GTshenmi/AI-SmartCar/AI Visual/SoftWare/Source Code/AIVisionCar/Example/example/readme.txt

使用软件
- Keil MDK 5.25
- IAR embedded Workbench 8.40（IAR8.40版本不支持中文路径）

波特率115200  8位数据位 1位停止位 没有奇偶校验

如果使用龙邱配套的DAPLINK 直接插上即可
如果使用串口模块（串口蓝牙，USB转TTL或者其他串口）
将 L14 连接串口模块（串口蓝牙）的 TX上
将 K14 连接串口模块（串口蓝牙）的 RX上
共地

一个例子工程，可以在这个上面构建自己的程序

128KB   ITCRAM   重要代码执行域
256KB   DTCRAM   常用数据域和栈
640KB   OCRAM    堆域和不常用数据域

注意如果下不进去程序，供电正常电源灯不亮请联系客服寄回维修
如果电源灯亮 请将核心板上的两个拨码开关拨到另一面，下载完成后再拨回来
