GTshenmi/AI-SmartCar/AI Visual/SoftWare/Source Code/AIVisionCar/更新说明.txt

2019/11/26  增加RT1064_IO分配说明

2019/11/25  增加1064必读说明

2019/11/25  更新入门手册至2.0版本

2019/11/25  替换PIT.c/.h以及SOFTIIC.c/.h  （已替换）

2019/10/15  优化模拟IIC驱动

2019/10/12  优化LQ_PIT.c 解决PIT通道1不能进入中断问题

2019/10/08  优化GPT驱动文件

2019/09/06  优化LQ_SYSTICK.c文件

2019/08/30  优化TFT1.8寸屏初始化程序，提高刷屏速度

2019/08/30  新增SD卡拍照存卡例程

2019/08/26  新增DMA内存To内存测试例程

2019/08/22  新增CAN收发例程

2019/08/19  新增LQ_GPIO.c驱动程序
