GTshenmi/AI-SmartCar/AI Electomagnetic/Simulation And Analysis/Correlation Analysis/模型分析/All.png

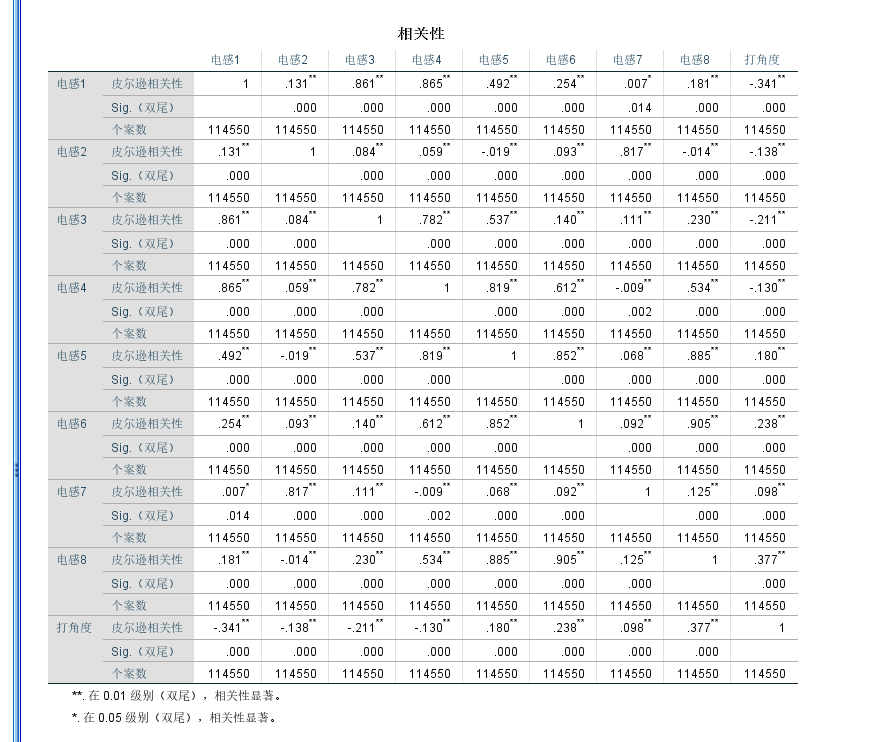
AI Electomagnetic/Simulation And Analysis/Correlation Analysis/模型分析/All.png
