GTshenmi/AI-SmartCar/AI Electomagnetic/Software/Template/TC377/SmartCar Code Structure.png

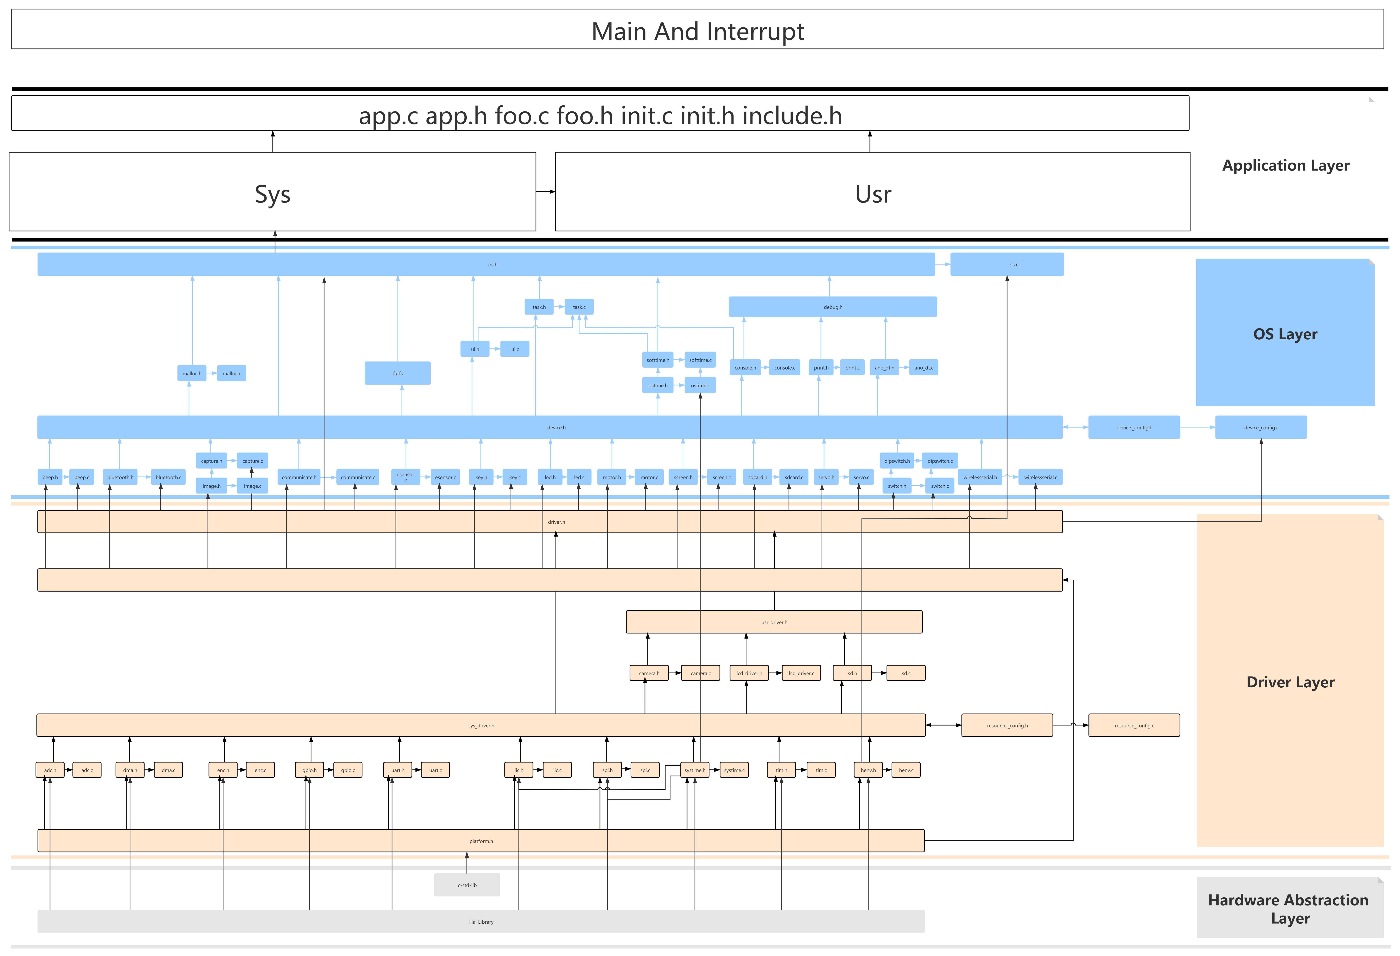
AI Electomagnetic/Software/Template/TC377/SmartCar Code Structure.png
