GTshenmi/AI-SmartCar/AI Electomagnetic/Simulation And Analysis/AI/train_dat/manual.txt

00 01 B4 80 D3 0C EE 80 CB 00 5A 
00 02 B4 80 D3 0C EE 80 CA 00 5A 
00 03 B5 81 D4 0C EF 80 CB BB 5A 
00 04 B5 81 D3 0D EE 80 CB BB 5A 
00 05 B5 80 D4 0C EE 80 CB D7 5A 
00 06 B5 81 D4 0C EE 80 CB D7 5A 
00 07 B5 81 D3 0C EF 80 CB D7 5A 
00 08 B5 81 D4 0C EF 80 CB D7 5A 
00 09 B5 80 D4 0D EF 81 CB D7 5A 
00 0A B5 81 D4 0C EF 81 CB CF 5A 
00 0B B4 81 D4 0C EE 80 CB CF 5A 
00 0C B5 81 D3 0C EE 80 CB CF 5A 
00 0D B6 81 D4 0D EF 81 CB D2 5A 
00 0E B5 80 D4 0C EF 80 CB D2 5A 
00 0F B5 81 D4 0C EE 80 CB D2 5A 
00 10 B5 80 D4 0C EF 80 CB D2 5A 
00 11 B5 81 D3 0C EE 80 CB D2 5A 
00 12 B4 81 D4 0D EF 80 CB D2 5A 
00 13 B5 80 D3 0C EF 80 CB D2 5A 
00 14 B5 81 D3 0C EE 80 CB DA 5A 
00 15 B5 81 D3 0C EF 80 CB DA 5A 
00 16 B5 81 D3 0C EE 80 CB DA 5A 
00 17 B5 81 D4 0C EE 81 CA CF 5A 
00 18 B5 81 D3 0C EE 80 CB CF 5A 
00 19 B5 80 D4 0C EE 80 CB DA 5A 
00 1A B5 81 D4 0D EE 80 CA DA 5A 
00 1B B4 81 D4 0C EE 80 CA DA 5A 
00 1C B5 81 D4 0C EE 80 CB D7 5A 
00 1D B5 81 D4 0C EE 80 CA D7 5A 
00 1E B5 81 D4 0C EE 80 CA D7 5A 
00 1F B5 81 D4 0C EE 80 CB D7 5A 
00 20 B5 80 D4 0C EE 80 CA D7 5A 
00 21 B5 81 D4 0D EE 80 CA DB 5A 
00 22 B5 80 D4 0C EE 81 CA DB 5A 
00 23 B5 81 D4 0C EE 80 CA D9 5A 
00 24 B5 80 D4 0D EE 80 CA D9 5A 
00 25 B5 80 D4 0D EE 80 CA D9 5A 
00 26 B5 81 D5 0D EE 80 CA D9 5A 
00 27 B6 81 D5 0D ED 80 CA D9 5A 
00 28 B5 81 D4 0D ED 80 C9 D9 5A 
00 29 B5 81 D5 0D ED 80 C9 D9 5A 
00 2A B7 81 D5 0D ED 81 CA D9 5A 
00 2B B6 80 D5 0D ED 80 C9 E1 5A 
00 2C B6 81 D5 0D ED 80 C9 E1 5A 
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
2D ED B8 80 D7 0D EA 81 C6 DC 5A 
2D EE B7 80 D7 0F EA 81 C7 D6 5A 
2D EF B7 81 D6 0F EB 81 C7 D6 5A 
2D F0 B6 80 D6 0E EB 81 C7 CD 5A 
2D F1 B7 80 D5 0F EC 82 C8 CD 5A 
2D F2 B6 80 D4 0D EC 82 C9 CD 5A 
2D F3 B6 80 D4 0E ED 82 C9 C2 5A 
2D F4 B6 80 D4 0E ED 82 C9 C2 5A
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
