GTshenmi/AI-SmartCar/AI Electomagnetic/Simulation And Analysis/AI/train_dat/train_dat/test.txt

S 5 S 1.440430 27.392580 26.293950 32.519530 40.869140 49.829100 1.708984 31.094920 E
S 1 S 1.440430 27.392580 26.293950 32.519530 40.869140 49.829100 1.708984 31.094920 E
S 2 S 1.440430 27.392580 26.293950 32.519530 40.869140 49.829100 1.708984 31.094920 E
S 3 S 1.440430 27.392580 26.293950 32.519530 40.869140 49.829100 1.708984 31.094920 E
S 4 S 1.440430 27.392580 26.293950 32.519530 40.869140 49.829100 1.708984 31.094920 E
S 5 S 1.440430 27.392580 26.293950 32.519530 40.869140 49.829100 1.708984 31.094920 E
S 1 S 1.440430 27.392580 26.293950 32.519530 40.869140 49.829100 1.708984 31.094920 E
S 2 S 1.440430 27.392580 26.293950 32.519530 40.869140 49.829100 1.708984 31.094920 E
