GTshenmi/AI-SmartCar/AI Electomagnetic/Hardware/Sheet/AI电磁运放板.pdf

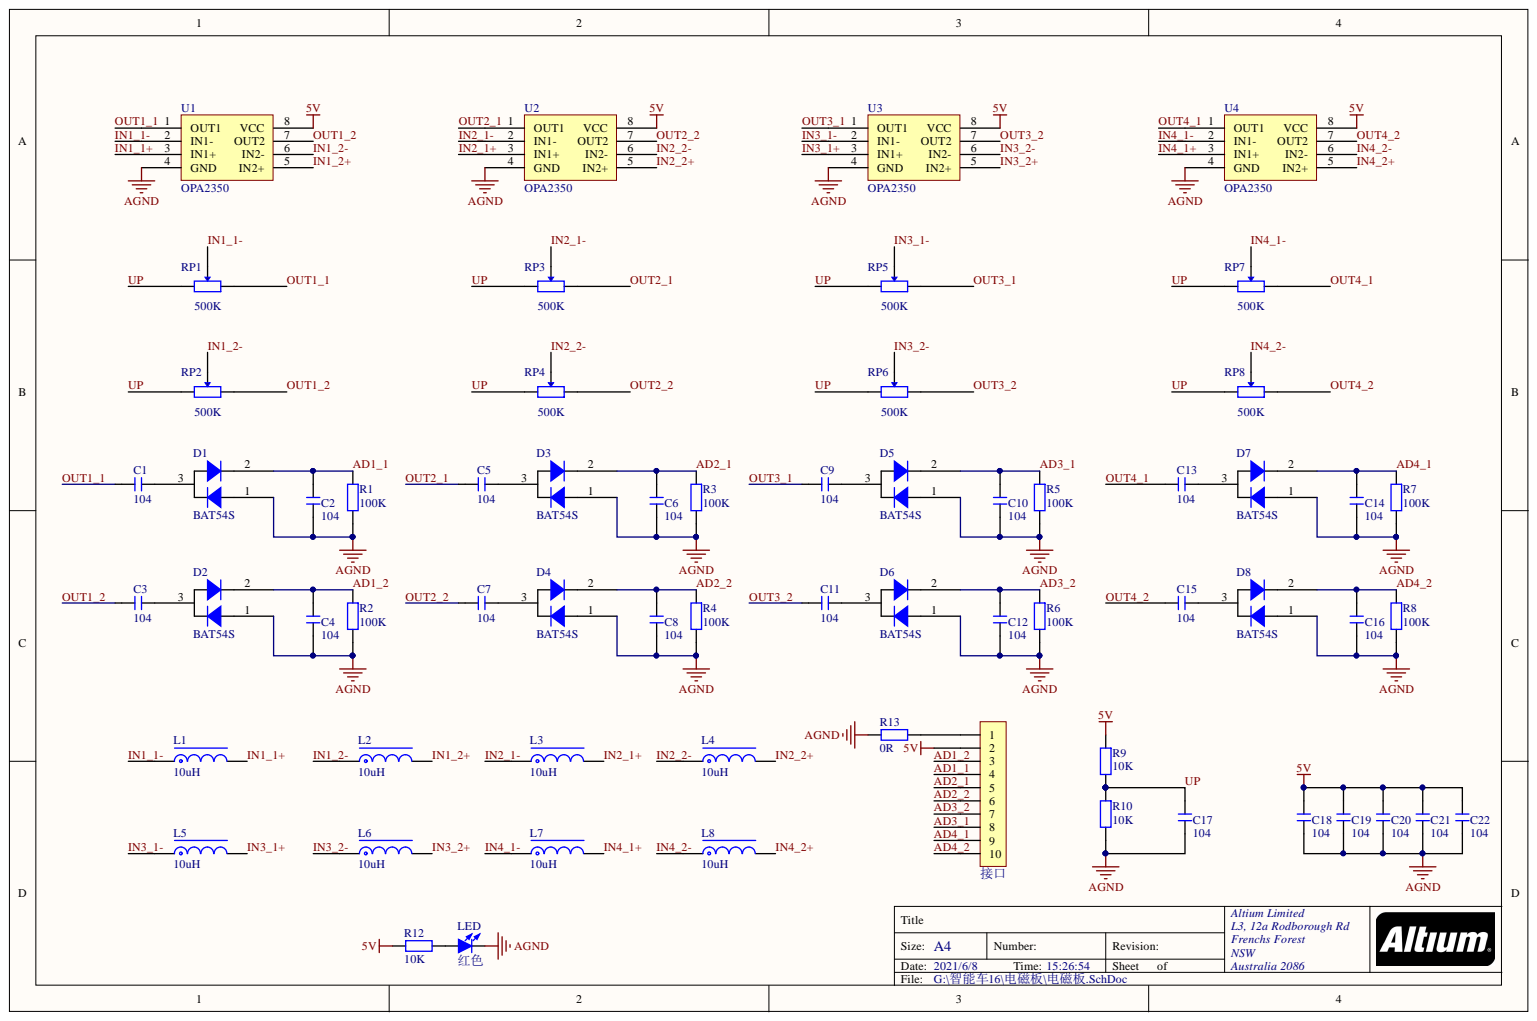
[picture p42: page 1]

Title | Altium Limited L3, 12a Rodborough Rd Frenchs Forest NSW Australia 2086

Size: A4 | Number: | Revision:
Date: 2021/6/8 Time: 15:26:54 | | Sheet of

Comment | Description | Designator | Footprint | LibRef | Quantity
104 | 无极性贴片电容 | C1, C2, C3, C4, C5, C6C 060 3_M | C | 22
BAT54S | D1, D2, D3, D4, D5, DSOT2 3 -3L | BAT54S | 8
10uH | 工字电感 | L1, L2, L3, L4, L5, L6, LPK0 406 | L-PK | 8
红色 | 贴片LED | LED | LED 0805G | LED-SMD | 1
100K | 贴片电阻 | R1, R2, R3, R4, R5, R6R 060 3_M | R | 8
10K | 贴片电阻 | R9, R10, R12 | R 0603_M | R | 3
0R | 贴片电阻 | R13 | R 0603_M | R | 1
500K | 插件单联电位器 | RP1, RP2, RP3, RP4, R329 6W | RP-ID | 8
OPA2350 | | U1, U2, U3, U4 | SOP8_M | OPA2350 | 4
FPC1.0-10P | FPC连接器 | 接口 | FPC0.5 2H-WS-10P | FPC-10P | 1
