GTshenmi/AI-SmartCar/AI Electomagnetic/Software/Source Code/SmartCar/OS/Device/ESensor/esensor.c

/*
 * esensor.c
 *
 *  Created on: 2020年12月6日
 *      Author: 936305695
 */
#include <esensor.h>
#include "driver.h"

uint16_t ESensor_Read(struct esensor *self)
{
    /*use filter*/
    if(self->ConfigReg & ESENSOR_BITS_FILTER_ENABLE_MASK)
        self->Cache = self->Filter(self,self->Argv,self->Argc);
    else
    {
#if ESENSOR_FAST_READ_LEVEL == ESENSOR_FAST_READ_LEVEL_0
        self->Cache = self->ReadADC(self);
#else
        self->Cache = ESensor_ReadADC(self);
#endif
    }
    /*use output gain*/
    if(self->ConfigReg & ESENSOR_BITS_GAIN_ENABLE_MASK)
        self->Cache = (uint16_t)((self->Cache) * self->Gain);

#if 0
    if(self->Cache * 1.0 > ADCx.MaxValue  * self->Gain)
        self->Cache = (uint16_t)ADCx.MaxValue * self->Gain;
#endif

    return self->Cache;
}

static unsigned ESensor_MidFilter(struct esensor *self)
{
    uint16_t i,j,k,tmp;

    //1.取3次A/D转换结果
#if ESENSOR_FAST_READ_LEVEL == ESENSOR_FAST_READ_LEVEL_0
    i = self->ReadADC(self);
    j = self->ReadADC(self);
    k = self->ReadADC(self);
#else
    i = ESensor_ReadADC(self);
    j = ESensor_ReadADC(self);
    k = ESensor_ReadADC(self);
#endif
    //2.取中值
    if (i > j)
    {
        tmp = i; i = j; j = tmp;
    }
    if (k > j)
        tmp = j;
    else if(k > i)
        tmp = k;
    else
        tmp = i;

    return tmp;
}

static uint16_t ESensor_SlidingMedianFilter(struct esensor *self,uint16_t *FilterBuf,uint16_t len,uint16_t new_data)
{
    for(sint16_t i = 0;i < len-1 ;i++)
        FilterBuf[i] = FilterBuf[i+1];
    FilterBuf[len-1] = new_data;

    uint16_t result = 0;

    for(sint16_t i = 0;i < len ;i++)
    {
        result += FilterBuf[i];
    }
    result /= len;

    return result;
}

uint16_t ESensor_SelfCalibration(struct esensor *self,float ref)
{
    float gain = 0.0;
    float ave = 0.0;
    float val = 0.0;

    for(int i = 0 ; i < 50 ; i++)
    {
        ave += (self->Read(self) * 100.0) / 4096.0;
    }
    
    ave = 0.0;

    for(int i = 0 ; i < 500 ; i++)
    {
        ave += (self->Read(self) * 100.0) / 4096.0;
    }
    
    ave /= 500.0;

    for(int i = 0 ; i < 500 ; i++)
    {
        val = (self->Read(self) * 100.0) / 4096.0;

        if(fabs(val - ave) >= 5.0)
        {
            i--;
        }
        else
        {
            if(fabs(val) >= 1e-6)
                gain += ref /val;
            else
                i--;
        }
    }

    gain /= 500.0;

    if(self->ConfigReg & ESENSOR_BITS_GAIN_ENABLE_MASK)
    {
        self->SetGain(self,gain);
    }

    if(ave >= 7.0 && ave <= 8.0)
    {
        return ESensor_NoConnection;
    }

    if(ave <= 1.0)
    {
        return ESensor_ValueTooSmall;
    }

    if(ave >= 99.9)
    {
        return ESensor_ValueTooLarge;
    }

    return ESensor_Normal;
}

uint16_t ESensor_Filter(struct esensor *self,void *argv,uint16_t argc)
{
    return ESensor_SlidingMedianFilter(self,self->FilterBuf,self->FilterBufLen,ESensor_MidFilter(self));
}

void ESensor_EnableFilter(struct esensor *self,bool enable)
{
    if(enable)
        self->ConfigReg |= ESENSOR_BITS_FILTER_ENABLE_MASK;
    else
        self->ConfigReg &= ~ESENSOR_BITS_FILTER_ENABLE_MASK;
}

void ESensor_EnableGain(struct esensor *self,bool enable)
{
    if(enable)
        self->ConfigReg |= ESENSOR_BITS_GAIN_ENABLE_MASK;
    else
        self->ConfigReg &= ~ESENSOR_BITS_GAIN_ENABLE_MASK;
}

void ESensor_SetGain(struct esensor *self,float gain)
{
    self->Gain = gain;
}

uint16_t ESensor_ReadFromCache(struct esensor *self)
{
    return self->Cache;
}

void ESensor_Connect(struct esensor *self,esensor_filtercallback filter,void *argv,uint16_t argc)
{
    self->Filter = filter;
    self->Argv = argv;
    self->Argc = argc;
}

#if ESENSOR_FAST_READ_LEVEL == ESENSOR_FAST_READ_LEVEL_0
uint16_t ESensor_ReadADC(struct esensor *self)
{
    return ADCx.Read(self->ADCn);
}
#endif

uint16_t ESensor_Init(struct esensor *self)
{
    ADCx.Init(self->ADCn);

    self->Argv = NULL;
    self->Argc = 0;
    self->Cache = 0;
    self->Gain = 0.0;
    self->ConfigReg = 0x00000000;
    
    self->FilterBufLen = 5;

    //memset(self->FilterBuf,0,sizeof(self->FilterBuf[0]) * self->FilterBufLen);

    self->Read = ESensor_Read;
    self->Filter = ESensor_Filter;
    self->EnableFilter = ESensor_EnableFilter;
    self->EnableGain = ESensor_EnableGain;
    self->SetGain = ESensor_SetGain;
    self->ReadFromCache = ESensor_ReadFromCache;
    self->Connect = ESensor_Connect;

#if ESENSOR_FAST_READ_LEVEL == ESENSOR_FAST_READ_LEVEL_0
    self->ReadADC = ESensor_ReadADC;
#endif

    self->SetGain(self,1.0);
    self->EnableFilter(self,true);
    self->EnableGain(self,false);
    self->Connect(self,ESensor_Filter,NULL,0);

    self->SelfCalibration = ESensor_SelfCalibration;

    return 0;
}
