GTshenmi/AI-SmartCar/AI Electomagnetic/Software/Template/TC377/Driver/SysDriver/sys_driver.h

/*
 * sysdriver.h
 *
 *  Created on: 2020Äê12ÔÂ6ÈÕ
 *      Author: 936305695
 */

#ifndef DRIVER_SYSDRIVER_SYS_DRIVER_H_
#define DRIVER_SYSDRIVER_SYS_DRIVER_H_

#include "common.h"
#include "platform.h"
#include "adc.h"
#include "enc.h"
#include "gpio.h"
#include "pwm.h"
#include "tim.h"
#include "uart.h"
#include "spi.h"
#include "iic.h"
#include "dma.h"
#include "systime.h"
#include "resource_config.h"


#endif /* DRIVER_SYSDRIVER_SYS_DRIVER_H_ */
