GTshenmi/AI-SmartCar/AI Electomagnetic/Software/Template/TC264/Driver/SysDriver/sys_driver.h

/*
 * sysdriver.h
 *
 *  Created on: 2020Äê12ÔÂ6ÈÕ
 *      Author: 936305695
 */

#ifndef DRIVER_SYSDRIVER_SYS_DRIVER_H_
#define DRIVER_SYSDRIVER_SYS_DRIVER_H_

#define TC264 0
#define TC377 1
#define RT1064 2
#define Other -1

#define Chip TC264

#define and &&
#define or ||
#define public /*public*/
#define private /*private*/

#include "sys_driverlq.h"
#include "chipdatatype.h"
#include "adc.h"
#include "enc.h"
#include "gpio.h"
#include "pwm.h"
#include "tim.h"
#include "uart.h"
#include "spi.h"
#include "iic.h"
#include "dma.h"
#include "systime.h"
#include "henv.h"
#include "resource_config.h"


#endif /* DRIVER_SYSDRIVER_SYS_DRIVER_H_ */
