GTshenmi/AI-SmartCar/AI Electomagnetic/Software/Template/TC264/src/AppSw/Tricore/User/LQ_PID.h

/*!
  * @file     LQ_PID.h
  *
  * @brief    
  *
  * @company  北京龙邱智能科技
  *
  * @author   LQ-005
  *
  * @note     Tab键 4个空格
  *
  * @version  V1.0
  *
  * @par URL  http://shop36265907.taobao.com
  *           http://www.lqist.cn
  *
  * @date     2020年6月5日
  */ 
#ifndef SRC_APPSW_TRICORE_USER_LQ_PID_H_
#define SRC_APPSW_TRICORE_USER_LQ_PID_H_

#include <stdint.h>

typedef struct
{
    float                kp;         //P
    float                ki;         //I
    float                kd;         //D
    float                imax;       //积分限幅

    float                out_p;  //KP输出
    float                out_i;  //KI输出
    float                out_d;  //KD输出
    float                out;    //pid输出

    float                integrator; //< 积分值
    float                last_error; //< 上次误差
    float                last_derivative;//< 上次误差与上上次误差之差
    unsigned long        last_t;     //< 上次时间
}pid_param_t;


void PidInit(pid_param_t * pid);

float constrain_float(float amt, float low, float high);

float PidLocCtrl(pid_param_t * pid, float error);

float PidIncCtrl(pid_param_t * pid, float error);

#endif /* SRC_APPSW_TRICORE_USER_LQ_PID_H_ */
