GTshenmi/AI-SmartCar/AI Electomagnetic/Software/Template/TC377/OS/os.c

/*
 * os.c
 *
 *  Created on: 2020Äê12ÔÂ12ÈÕ
 *      Author: 936305695
 */
#include "os.h"

void OS_Init(uint core)
{
    switch(core)
    {
        case 0:
            os.time.init();
            os.softtimer.init();
            break;
        case 1:
            break;
        case 2:
            break;
        default:
            break;
    }
}

os_t os =
{
        .init = OS_Init,
        .time = {
                .init = OSTime_Init,
                .now = OSTime_Now,
                .delayms = OSTime_Delayms,
                .delayus = OSTime_Delayus,
                .delays = OSTime_Delays,
                .delay  =  OSTime_Delay,

                .getnmsFlag = OSTime_GetnmsFlag,
                .getTimeus = OSTime_Get_Timeus,
                .getTimems = OSTime_Get_Timems,
                .getTimes = OSTime_Get_Times,
                .getTime = OSTime_Get_Time,

        },
        .softtimer = {
                .init = SoftTimerInit,

                .start = SoftTimerStart,
                .update = SoftTimerUpdate,
                .stop = SoftTimerStop,
                .getStates = SoftTimerGetStates,
                .findFreeTimer = SoftTimerFindFreeTimer,
        },
        .path =
        {
                .exist = FileSys_PathIsExists,
        },
        .file =
        {
                .init = FileSys_Init,
        },
        .task = {
                .KeyScan = Task_KeyScan,
                .SoftTimerUpdate = Task_SoftTimerUpdate,
                .UiUpdate = Task_UiUpdate,
                .DebugConsole = Task_DebugConsole,
        },
};
