GTshenmi/AI-SmartCar/AI Electomagnetic/Software/Template/TC377/interrupt.c

/*
 * interrupt.c
 *
 *  Created on: 2020年12月6日
 *      Author: 936305695
 */
#include "include.h"

attitude_t attitude;
axis_t acc,gyro;

void STM0_CH1_IRQHandler(void)
{
    /* 开启CPU中断  否则中断不可嵌套 */
    IfxCpu_enableInterrupts();

    //清除中断标志
    IfxStm_clearCompareFlag(&MODULE_STM0, g_StmCompareConfig[1].comparator);

    //开启新的中断配置，开始下次中断
    IfxStm_increaseCompare(&MODULE_STM0, g_StmCompareConfig[1].comparator, g_StmCompareConfig[1].ticks);


    //BEEP.Toggle(BEEP.Self);

    // //dt = os.time.getTime(ms);

    // ICM20602_ReadAcc(&acc.x,&acc.y,&acc.z);

    // ICM20602_ReadGyro(&gyro.x,&gyro.y,&gyro.z);

    // //dt = os.time.getTime(ms) - dt;

    // AttitudeUpdate(&acc,&gyro,NULL,&attitude);
}


uint32_t dt = 0.0;

void STM1_CH0_IRQHandler(void)           /*Calculate Bias.*/
{
    /* 开启CPU中断  否则中断不可嵌套 */
    IfxCpu_enableInterrupts();

    //清除中断标志
    IfxStm_clearCompareFlag(&MODULE_STM1, g_StmCompareConfig[2].comparator);

    //开启新的中断配置，开始下次中断
    IfxStm_increaseCompare(&MODULE_STM1, g_StmCompareConfig[2].comparator, g_StmCompareConfig[2].ticks);

    //uint32_t sTime = os.time.getTimeus();

    ESensorDataAnalysis(&Data[data_pointer]);

    //dt = os.time.getTimeus() - sTime;
    

}

void STM1_CH1_IRQHandler(void)       /*Servo Control.*/
{
    /* 开启CPU中断  否则中断不可嵌套 */
    IfxCpu_enableInterrupts();

    //清除中断标志
    IfxStm_clearCompareFlag(&MODULE_STM1, g_StmCompareConfig[3].comparator);

    //开启新的中断配置，开始下次中断
    IfxStm_increaseCompare(&MODULE_STM1, g_StmCompareConfig[3].comparator, g_StmCompareConfig[3].ticks);

    AngleControl(&Data[data_pointer]);  //角度控制
}

void CCU60_CH0_IRQHandler (void) /*Motor Control.*/
{
    /* 开启CPU中断  否则中断不可嵌套 */
    IfxCpu_enableInterrupts();

    //清除中断标志
    IfxCcu6_clearInterruptStatusFlag(&MODULE_CCU60, IfxCcu6_InterruptSource_t12PeriodMatch);

    /* 用户代码 */

    SpeedControl(&Data[data_pointer]);  //速度控制
}

void CCU60_CH1_IRQHandler (void)
{
    /* 开启CPU中断  否则中断不可嵌套 */
    IfxCpu_enableInterrupts();

    //清除中断标志
    IfxCcu6_clearInterruptStatusFlag(&MODULE_CCU60, IfxCcu6_InterruptSource_t13PeriodMatch);

    if(IMU.Is_Init)
        IMU.SetUpdateFlags(IMU.Self,true);
}

void CCU61_CH0_IRQHandler(void)
{
    /* 开启CPU中断  否则中断不可嵌套 */
    IfxCpu_enableInterrupts();

    //清除中断标志
    IfxCcu6_clearInterruptStatusFlag(&MODULE_CCU61, IfxCcu6_InterruptSource_t12PeriodMatch);

}

void CCU61_CH1_IRQHandler (void)
{
    /* 开启CPU中断  否则中断不可嵌套 */
    IfxCpu_enableInterrupts();

    //清除中断标志
    IfxCcu6_clearInterruptStatusFlag(&MODULE_CCU61, IfxCcu6_InterruptSource_t13PeriodMatch);

    /* 用户代码 */
}


/*************************************************************************
*  函数名称：PIN_INT0_IRQHandler中断服务函数
*  功能说明：
*  参数说明：无
*  函数返回：无
*  修改时间：2020年3月30日
*  备    注：外部中断0组管脚 使用的中断服务函数
*************************************************************************/
void PIN_INT0_IRQHandler(void)
{
    /* 用户代码 */
}

/*************************************************************************
*  函数名称：PIN_INT1_IRQHandler中断服务函数
*  功能说明：
*  参数说明：无
*  函数返回：无
*  修改时间：2020年3月30日
*  备    注：外部中断1组管脚 使用的中断服务函数
*************************************************************************/
void PIN_INT1_IRQHandler(void)
{
    /* 用户代码 */
}

/*************************************************************************
*  函数名称：PIN_INT2_IRQHandler中断服务函数
*  功能说明：
*  参数说明：无
*  函数返回：无
*  修改时间：2020年3月30日
*  备    注：外部中断2组管脚 使用的中断服务函数
*************************************************************************/
void PIN_INT2_IRQHandler(void)
{
    // 用户代码
}

/*************************************************************************
*  函数名称：PIN_INT3_IRQHandler中断服务函数
*  功能说明：
*  参数说明：无
*  函数返回：无
*  修改时间：2020年3月30日
*  备    注：外部中断3组管脚 使用的中断服务函数
*************************************************************************/
void PIN_INT3_IRQHandler(void)
{
    // 用户代码
    //DMA_CameraStart(PIN_INT2_PRIORITY);

}

/**
  * @brief    QSPI0_RX_IRQHandler中断服务函数
  * @note     QSPI0 接收中断服务函数
  */
void QSPI0_RX_IRQHandler(void)
{
    IfxQspi_SpiMaster_isrReceive(&g_QSPIConfig[0]);

    /* 用户代码 */
}

void QSPI0_TX_IRQHandler(void)
{
    IfxQspi_SpiMaster_isrTransmit(&g_QSPIConfig[0]);
    /* 用户代码 */
}

void QSPI0_ER_IRQHandler(void)
{
    IfxQspi_SpiMaster_isrError(&g_QSPIConfig[0]);
    /* 用户代码 */
}

void QSPI1_RX_IRQHandler(void)
{
    IfxQspi_SpiMaster_isrReceive(&g_QSPIConfig[1]);
    /* 用户代码 */
}

void QSPI1_TX_IRQHandler(void)
{
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
{
    SRC_GPSR10.B.SRR = 0;
    /* 用户代码 */
}

void CPU2_SOFT_IRQ1Handler (void)
{
    SRC_GPSR11.B.SRR = 0;
    /* 用户代码 */
}

void CPU2_SOFT_IRQ2Handler (void)
{
    SRC_GPSR12.B.SRR = 0;
    /* 用户代码 */
}

void CPU2_SOFT_IRQ3Handler (void)
{
    SRC_GPSR13.B.SRR = 0;
    /* 用户代码 */
}
