GTshenmi/AI-SmartCar/TC377Project/SmartCar/Driver/UsrDriver/SD/sd.h

#ifndef _MMC_SD_H_
#define _MMC_SD_H_		 

#include "sys_driver.h"

#define SD_SPI           &SPI_Resources[1].SPIN

#define SD_SPI_CS_GPIO   &GPIO_Resources[22].GPION

#define SD_SPI_CLK_GPIO  NULL
#define SD_SPI_MOSI_GPIO NULL
#define SD_SPI_MOSO_GPIO NULL

#define SD_GPIO_Write(gpio,x) GPIOx.Write((gpio),(x))
#define SD_GPIO_Read(gpio)    GPIOx.Read(gpio)

#define W_SD_SPI_CS(x) SD_GPIO_Write((SD_SPI_CS_GPIO),(x))
#define W_SD_SPI_CLK(x) SD_GPIO_Write((SD_SPI_CLK_GPIO),(x))
#define W_SD_SPI_MOSI(x) SD_GPIO_Write((SD_SPI_MOSI_GPIO),(x))
#define W_SD_SPI_MOSO(x) SD_GPIO_Write((SD_SPI_MOSO_GPIO),(x))

#define R_SD_SPI_CS(x) SD_GPIO_Read((SD_SPI_CS_GPIO))
#define R_SD_SPI_CLK(x) SD_GPIO_Read((SD_SPI_CLK_GPIO))
#define R_SD_SPI_MOSI(x) SD_GPIO_Read((SD_SPI_MOSI_GPIO))
#define R_SD_SPI_MOSO(x) SD_GPIO_Read((SD_SPI_MOSO_GPIO))


#define SD_USING_HARDWARE_CTRL 1

#if SD_USING_HARDWARE_CTRL
#define SD_SPIReadWriteByte SD_HardWareReadWriteByte
#else
#define SD_SPIReadWriteByte SD_SoftWareReadWriteByte
#endif

 //SD卡类型定义
#define SD_TYPE_ERR     0X00
#define SD_TYPE_MMC     0X01
#define SD_TYPE_V1      0X02
#define SD_TYPE_V2      0X04
#define SD_TYPE_V2HC    0X06
// SD卡指令表
#define CMD0    0       //卡复位
#define CMD1    1
#define CMD8    8       //命令8 ，SEND_IF_COND
#define CMD9    9       //命令9 ，读CSD数据
#define CMD10   10      //命令10，读CID数据
#define CMD12   12      //命令12，停止数据传输
#define CMD16   16      //命令16，设置SectorSize 应返回0x00
#define CMD17   17      //命令17，读sector
#define CMD18   18      //命令18，读Multi sector
#define CMD23   23      //命令23，设置多sector写入前预先擦除N个block
#define CMD24   24      //命令24，写sector
#define CMD25   25      //命令25，写Multi sector
#define CMD41   41      //命令41，应返回0x00
#define CMD55   55      //命令55，应返回0x01
#define CMD58   58      //命令58，读OCR信息
#define CMD59   59      //命令59，使能/禁止CRC，应返回0x00
//数据写入回应字意义
#define MSD_DATA_OK                0x05
#define MSD_DATA_CRC_ERROR         0x0B
#define MSD_DATA_WRITE_ERROR       0x0D
#define MSD_DATA_OTHER_ERROR       0xFF
//SD卡回应标记字
#define MSD_RESPONSE_NO_ERROR      0x00
#define MSD_IN_IDLE_STATE          0x01
#define MSD_ERASE_RESET            0x02
#define MSD_ILLEGAL_COMMAND        0x04
#define MSD_COM_CRC_ERROR          0x08
#define MSD_ERASE_SEQUENCE_ERROR   0x10
#define MSD_ADDRESS_ERROR          0x20
#define MSD_PARAMETER_ERROR        0x40
#define MSD_RESPONSE_FAILURE       0xFF

extern uint8_t  SD_Type;			//SD卡的类型

uint8_t SD_Initialize(void *config);

uint8_t SD_ReadSector(uint32_t sector,uint32_t page,uint8_t *buf,uint32_t len);
uint8_t SD_WriteSector(uint32_t sector,uint32_t page,uint8_t *buf,uint32_t len);

uint32_t SD_GetSectorCount(void);
 
#endif
