GTshenmi/AI-SmartCar/AI Electomagnetic/Software/Template/TC264/OS/os.c

/*
 * os.c
 *
 *  Created on: 2020Äê12ÔÂ12ÈÕ
 *      Author: 936305695
 */
#include "os.h"

#define SysRandADC NULL

uint16_t GetRandNumberFromADC()
{
    return ADCx.Read(SysRandADC);
}

void OS_Init(uint core)
{
    os.core[core].HEnvInit();
    switch(core)
    {
        case 0:
            os.time.init();
            os.softtimer.init();
            os.file.init();
            break;
        case 1:
            break;
        case 2:
            break;
        default:
            break;
    }
    os.core[core].HardWareInit();
    os.core[core].SoftWareInit();
    os.core[core].WaitForSync(NULL);
}

os_t os =
{
        .init = OS_Init,
        .core =
        {
                [0] = {
                          .HEnvInit = Core0_HardWareEnvInit,
                          .WaitForSync = Core0_WaitForSync,
                },
                [1] = {
                          .HEnvInit = Core1_HardWareEnvInit,
                          .WaitForSync = Core1_WaitForSync,
                },
                [2] = {
                          .HEnvInit = Core2_HardWareEnvInit,
                          .WaitForSync = Core2_WaitForSync,
                },
        },
        .time = {
                .init = OSTime_Init,
                .now = OSTime_Now,
                .delayms = OSTime_Delayms,
                .delayus = OSTime_Delayus,
                .delays = OSTime_Delays,
                .delay  =  OSTime_Delay,
                .getTimeus = OSTime_Get_Timeus,
                .getTimems = OSTime_Get_Timems,
                .getTimes = OSTime_Get_Times,
                .getTime = OSTime_Get_Time,

        },
        .softtimer = {
                .init = SoftTimerInit,

                .start = SoftTimerStart,
                .update = SoftTimerUpdate,
                .stop = SoftTimerStop,
                .getStates = SoftTimerGetStates,
                .findFreeTimer = SoftTimerFindFreeTimer,
        },
        .path =
        {
                .exist = FileSys_PathIsExists,
        },
        .file =
        {
                .init = FileSys_Init,
        },
        .task = {
                .KeyScan = Task_KeyScan,
                .SoftTimerUpdate = Task_SoftTimerUpdate,
                .UiUpdate = Task_UiUpdate,
                .DebugConsole = Task_DebugConsole,
        },
};
