GTshenmi/AI-SmartCar/AI Electomagnetic/Software/Template/TC264/Driver/SysDriverLQ/LQ_SOFTI2C.h

/*LLLLLLLLLLLLLLLLLLLLLLLLLLLLLLLLLLLLLLLLLLLLLLLLLLLLLLLLLLLLLL
【平    台】北京龙邱智能科技TC264DA核心板
【编    写】ZYF/chiusir
【E-mail  】chiusir@163.com
【软件版本】V1.1 版权所有，单位使用请先联系授权
【最后更新】2020年10月28日
【相关信息参考下列地址】
【网    站】http://www.lqist.cn
【淘宝店铺】http://longqiu.taobao.com
------------------------------------------------
【dev.env.】AURIX Development Studio1.2.2及以上版本
【Target 】 TC264DA/TC264D
【Crystal】 20.000Mhz
【SYS PLL】 200MHz
________________________________________________________________
基于iLLD_1_0_1_11_0底层程序,

使用例程的时候，建议采用没有空格的英文路径，
除了CIF为TC264DA独有外，其它的代码兼容TC264D
本库默认初始化了EMEM：512K，如果用户使用TC264D，注释掉EMEM_InitConfig()初始化函数。
工程下\Libraries\iLLD\TC26B\Tricore\Cpu\CStart\IfxCpu_CStart0.c第164行左右。
QQQQQQQQQQQQQQQQQQQQQQQQQQQQQQQQQQQQQQQQQQQQQQQQQQQQQQQQQQQQQQQ*/
#ifndef __LQ_SOFTIIC_H
#define __LQ_SOFTIIC_H

#include "Cpu/Std/Platform_Types.h"
#include "stdint.h"

#include "../SysDriverLQ/LQ_GPIO.h"

/* 注意 IIC总线规定，IIC空闲时 SCL和SDA都为高电平 最好外部上拉（一定不能下拉） */
/* 模拟 IIC需要注意，IIC地址左移一位 例如MPU6050 模拟就是地址 0xD0 */
/* 想换用别的IO 直接修改宏定义 SOFT_IIC_SCL_PIN 、 SOFT_IIC_SDA_PIN 即可 */
#define SOFT_IIC_SCL_PIN   P13_1   /*!< P13_1  作为 SCL */
#define SOFT_IIC_SDA_PIN   P13_2   /*!< P13_2  作为 SDA */

#define SDA_OUT        PIN_Dir(SOFT_IIC_SDA_PIN, 1);
#define SDA_IN         PIN_Dir(SOFT_IIC_SDA_PIN, 0);

#define IIC_SCL_INIT   PIN_InitConfig(SOFT_IIC_SCL_PIN, PIN_MODE_OUTPUT, 1);
#define IIC_SDA_INIT   PIN_InitConfig(SOFT_IIC_SDA_PIN, PIN_MODE_OUTPUT, 1);

#define IIC_SCL_H      PIN_Write(SOFT_IIC_SCL_PIN, 1);
#define IIC_SCL_L      PIN_Write(SOFT_IIC_SCL_PIN, 0);

#define IIC_SDA_H      PIN_Write(SOFT_IIC_SDA_PIN, 1);
#define IIC_SDA_L      PIN_Write(SOFT_IIC_SDA_PIN, 0);

#define IIC_SDA_READ   PIN_Read(SOFT_IIC_SDA_PIN)

void IIC_Start(void);			    //发送IIC开始信号
void IIC_Stop(void);	  	        //发送IIC停止信号
void IIC_Ack(void);					//IIC发送ACK信号
void IIC_NAck(void);				//IIC不发送ACK信号
unsigned char IIC_WaitAck(void); 		    //IIC等待ACK信号
void IIC_SendByte(unsigned char data_t);    //IIC发送一个字节
unsigned char IIC_ReadByte(unsigned char ack);      //IIC读取一个字节


void IIC_Init(void);
unsigned char IIC_ReadByteFromSlave(unsigned char I2C_Addr,unsigned char reg,unsigned char *buf);
unsigned char IIC_ReadMultByteFromSlave(unsigned char dev, unsigned char reg, unsigned char length, unsigned char *data_t);
unsigned char IIC_WriteByteToSlave(unsigned char I2C_Addr,unsigned char reg,unsigned char buf);
unsigned char IIC_WriteMultByteToSlave(unsigned char dev, unsigned char reg, unsigned char length, unsigned char* data_t);

#endif
