GTshenmi/AI-SmartCar/AI Electomagnetic/Software/Template/TC264/Driver/SysDriverLQ/LQ_UART.h

/*LLLLLLLLLLLLLLLLLLLLLLLLLLLLLLLLLLLLLLLLLLLLLLLLLLLLLLLLLLLLLL
【平    台】北京龙邱智能科技TC264DA核心板
【编    写】ZYF/chiusir
【E-mail  】chiusir@163.com
【软件版本】V1.1 版权所有，单位使用请先联系授权
【最后更新】2020年10月28日
【相关信息参考下列地址】
【网    站】http://www.lqist.cn
【淘宝店铺】http://longqiu.taobao.com
------------------------------------------------
【dev.env.】AURIX Development Studio1.2.2及以上版本
【Target 】 TC264DA/TC264D
【Crystal】 20.000Mhz
【SYS PLL】 200MHz
________________________________________________________________
基于iLLD_1_0_1_11_0底层程序,

使用例程的时候，建议采用没有空格的英文路径，
除了CIF为TC264DA独有外，其它的代码兼容TC264D
本库默认初始化了EMEM：512K，如果用户使用TC264D，注释掉EMEM_InitConfig()初始化函数。
工程下\Libraries\iLLD\TC26B\Tricore\Cpu\CStart\IfxCpu_CStart0.c第164行左右。
ASC异步串行通信，可以作为UART和汽车LIN总线使用，
QQQQQQQQQQQQQQQQQQQQQQQQQQQQQQQQQQQQQQQQQQQQQQQQQQQQQQQQQQQQQQQ*/
#ifndef _LQ_ASC_H_
#define _LQ_ASC_H_

#include <Platform_Types.h>
#include <stdint.h>
#include <Ifx_Fifo.h>
#include <Ifx_Types.h>
#include <IfxAsclin.h>
#include <IfxAsclin_Asc.h>
#include <IfxAsclin_PinMap.h>
#include <IfxCpu.h>
#include <IfxCpu_Irq.h>
#include <IfxPort.h>
#include <IfxPort_regdef.h>


/** UART0接收中断服务函数优先级   范围：1-255   数字越大 优先级越高  注意优先级不要重复 */
#define  UART0_RX_PRIORITY    120

/** UART0发送中断服务函数优先级   范围：1-255   数字越大 优先级越高  注意优先级不要重复 */
#define  UART0_TX_PRIORITY    121

/** UART0错误中断服务函数优先级   范围：1-255   数字越大 优先级越高  注意优先级不要重复 */
#define  UART0_ER_PRIORITY    122

/** UART0中断服务函数优先级 中断归哪个内核管理？ 范围：0：CPU0   1：CPU1   3：DMA*/
#define  UART0_VECTABNUM    0


/** UART1接收中断服务函数优先级   范围：1-255   数字越大 优先级越高  注意优先级不要重复 */
#define  UART1_RX_PRIORITY    130

/** UART1发送中断服务函数优先级   范围：1-255   数字越大 优先级越高  注意优先级不要重复 */
#define  UART1_TX_PRIORITY    131

/** UART1错误中断服务函数优先级   范围：1-255   数字越大 优先级越高  注意优先级不要重复 */
#define  UART1_ER_PRIORITY    132

/** UART1中断服务函数优先级 中断归哪个内核管理？ 范围：0：CPU0   1：CPU1   3：DMA*/
#define  UART1_VECTABNUM    0


/** UART2接收中断服务函数优先级   范围：1-255   数字越大 优先级越高  注意优先级不要重复 */
#define  UART2_RX_PRIORITY    140

/** UART2发送中断服务函数优先级   范围：1-255   数字越大 优先级越高  注意优先级不要重复 */
#define  UART2_TX_PRIORITY    141

/** UART2错误中断服务函数优先级   范围：1-255   数字越大 优先级越高  注意优先级不要重复 */
#define  UART2_ER_PRIORITY    142

/** UART2中断服务函数优先级 中断归哪个内核管理？ 范围：0：CPU0   1：CPU1   3：DMA*/
#define  UART2_VECTABNUM    0


/** UART3接收中断服务函数优先级   范围：1-255   数字越大 优先级越高  注意优先级不要重复 */
#define  UART3_RX_PRIORITY    150

/** UART3发送中断服务函数优先级   范围：1-255   数字越大 优先级越高  注意优先级不要重复 */
#define  UART3_TX_PRIORITY    151

/** UART3错误中断服务函数优先级   范围：1-255   数字越大 优先级越高  注意优先级不要重复 */
#define  UART3_ER_PRIORITY    152

/** UART3中断服务函数优先级 中断归哪个内核管理？ 范围：0：CPU0   1：CPU1   3：DMA*/
#define  UART3_VECTABNUM    0

/**
  * @brief UART 枚举
  */
typedef enum
{
	UART0 = 0,
	UART1,
	UART2,
	UART3
}UART_t;

//L.Q UART RX 管脚枚举
typedef enum
{
	UART0_RX_P14_1 = 0xB401, UART0_RX_P15_3 = 0xB503,

	UART1_RX_P02_3 = 0xA203, UART1_RX_P11_10= 0xB10A, UART1_RX_P15_1 = 0xB501, UART1_RX_P15_5 = 0xB505, UART1_RX_P20_9 = 0xC009, UART1_RX_P33_13= 0xD30D,

	UART2_RX_P02_0 = 0xA200, UART2_RX_P02_1 = 0xA201, UART2_RX_P10_6 = 0xB006, UART2_RX_P14_3 = 0xB403, UART2_RX_P33_8 = 0xD308,

	UART3_RX_P00_1 = 0xA001, UART3_RX_P15_7 = 0xB507, UART3_RX_P20_3 = 0xC003, UART3_RX_P21_6 = 0xC106

}UART_RX_t;


//L.Q UART TX 管脚枚举
typedef enum
{
	UART0_TX_P14_0 = 0xB400, UART0_TX_P14_1 = 0xB401, UART0_TX_P15_2 = 0xB502, UART0_TX_P15_3 = 0xB503,

	UART1_TX_P02_2 = 0xA202, UART1_TX_P11_12= 0xB10C, UART1_TX_P15_0 = 0xB500, UART1_TX_P15_1 = 0xB501, UART1_TX_P15_4 = 0xB504, UART1_TX_P15_5 = 0xB505, UART1_TX_P20_10= 0xC00A, UART1_TX_P33_12= 0xD30C, UART1_TX_P33_13 = 0xD30D,

	UART2_TX_P02_0 = 0xA200, UART2_TX_P10_5 = 0xB005, UART2_TX_P14_2 = 0xB402, UART2_TX_P14_3 = 0xB403, UART2_TX_P33_8 = 0xD308, UART2_TX_P33_9 = 0xD309,

	UART3_TX_P00_0 = 0xA000, UART3_TX_P00_1 = 0xA001, UART3_TX_P15_6 = 0xB506, UART3_TX_P15_7 = 0xB507, UART3_TX_P20_0 = 0xC000, UART3_TX_P20_3 = 0xC003, UART3_TX_P21_7 = 0xC107

}UART_TX_t;

extern IfxAsclin_Asc g_UartConfig[4];


void UART_InitConfig(UART_RX_t RxPin, UART_TX_t TxPin, unsigned long baudrate);
void UART_PutChar(UART_t  uratn, char ch);
void UART_PutStr(UART_t  uratn, char *str);
void UART_PutBuff(UART_t  uratn, unsigned char *buff, unsigned long len);
uint8 UART_GetCount(UART_t  uratn);
char UART_GetChar(UART_t  uratn);
char UART_GetBuff(UART_t  uratn, unsigned char *data, unsigned char len);

#endif /* 0_APPSW_TRICORE_APP_LQ_ASC_H_ */
