GTshenmi/AI-SmartCar/AI Electomagnetic/Software/Template/TC377/OS/devices_config.h

/*
 * devices_config.h
 *
 *  Created on: 2021Äê1ÔÂ22ÈÕ
 *      Author: 936305695
 */

#ifndef OS_DEVICES_CONFIG_H_
#define OS_DEVICES_CONFIG_H_

#include "device.h"

#define MAX_LESENSOR_NUM    7
#define MAX_SESENSOR_NUM    8
#define MAX_KEY_NUM         6

extern beep_t BEEP;

extern bluetooth_t Bluetooth;

extern communicate_t CUART;
extern communicate_t DebugCom;

extern esensor_t LESensor[MAX_LESENSOR_NUM];
extern esensor_t SESensor[MAX_SESENSOR_NUM];

extern key_t KEY[MAX_KEY_NUM];

extern led_t GLED;
extern led_t BLED;

extern motor_ctrl_t Motor;

extern screen_t Screen;

extern imu_t IMU;

extern memory_t SDCard;
extern memory_t EEPROM;

extern servo_ctrl_t Servo;

extern switch_t Switch[8];
extern dip_switch_t DIPSwitch;

extern wireless_serial_t WirelessSerial;

extern dsensor_t DSensor;

#endif /* OS_DEVICES_CONFIG_H_ */
