GTshenmi/AI-SmartCar/AI Electomagnetic/Software/Template/TC377/Driver/SysDriver/dma.c

/*
 * dma.c
 *
 *  Created on: 2020Äê12ÔÂ14ÈÕ
 *      Author: 936305695
 */
#include "dma.h"

uint8_t DMAx_Init(dmax_t *dma)
{
    return 0;
}
uint8_t DMAx_Start(dmax_t *dma)
{
    return 0;
}
uint8_t DMAx_Stop(dmax_t *dma)
{
    return 0;
}

sdma_m DMAx =
{
        .Init = DMAx_Init,
        .Start = DMAx_Start,
        .Stop = DMAx_Stop,
};
