GTshenmi/AI-SmartCar/AI Electomagnetic/Software/Template/TC377/Driver/SysDriver/enc.h

/*
 * enc.h
 *
 *  Created on: 2020Äê12ÔÂ3ÈÕ
 *      Author: GT_shenmi
 */

#ifndef DRIVER_SYSDRIVERLQ_ENC_H_
#define DRIVER_SYSDRIVERLQ_ENC_H_

/*Platform HardWare Related Code Begin.*/

#include "common.h"
#include "platform.h"

/*Platform HardWare Related Code End.*/

typedef struct
{
        ENC_InputPin_t InputPin;
        ENC_DirPin_t DirPin;
}encx_t;
typedef struct
{
        uint8_t (*Init)(encx_t *);
        sint16_t (*Read)(encx_t *);
}senc_m;

extern senc_m ENCx;
#endif /* DRIVER_SYSDRIVERLQ_ENC_H_ */
