GTshenmi/AI-SmartCar/(commit log)

2021-02-13 V1.0.0
    None.
    [Configuration.h, ConfigurationIsr.h, mkfs.xls]
2021-02-16 V1.0.2
    Fix bug for pid control.
2021-02-16 V1.0.5
    Update Capture Device.
2021-02-19 V1.0.11
    fix lcd driver bug.
    [lcd_driver.c]
2021-02-21 Optimized some code.
    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
    [Configuration.h, ConfigurationIsr.h]
2021-02-26 Fixed ANO coding error.
    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
    [devices_config.c, devices_config.h]
2021-03-10 Fix Some Bug.
    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
    [Configuration.h, ConfigurationIsr.h, mkfs.xls]
2021-03-14 Fix Bug.
    Fix Screen Bug.
    Fix Capture Bug.
    [Configuration.h, ConfigurationIsr.h]
2021-03-14 Increase LCD Refresh Speed.
    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
    [Configuration.h, ConfigurationIsr.h]
2021-03-14 None.
    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
    [Configuration.h, ConfigurationIsr.h]
2021-03-22 Update UI.
    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
    [Configuration.h, ConfigurationIsr.h]
2021-03-25 20210325
    20210325
    [Configuration.h, ConfigurationIsr.h]
2021-03-26 LCD Use HardWare SPI.
    LCD Use HardWare SPI.
2021-03-29 优化工程.
    优化工程.
2021-04-01 Fix Bugs.
    降低了对LQ Lib 的依赖.
    3核心可用
    [Cpu0_Main.c, Cpu1_Main.c, Cpu2_Main.c, LQ_ADC.c, LQ_CCU6.c, LQ_CCU6.h, LQ_DMA.c, LQ_DMA.h]
2021-04-01 优化代码.
    优化代码.
2021-04-03 更新了存储设备
    更新了存储设备
2021-04-04 20210404
    更新Memory.
    优化Callback.
2021-04-07 Update SD Card Driver.
    Update SD Card Driver.
2021-04-10 Update.
    Update Fatfs.
    Update UI.
    [Configuration.h, ConfigurationIsr.h]
2021-04-13 Update.
    Update Motor Device.
    Update Motor PID.
2021-04-18 Update.
    Update Init Flow.
2021-04-24 Update.
    Update Gyro.
    Change SD High Speed Baudrate.
    [Configuration.h, ConfigurationIsr.h]
2021-04-25 Update.
    存在问题：
    短前瞻仍有问题。
    短前瞻ADC有个引脚读数为4096.
    舵机测试正常.
    电机新板不正常 旧板子正常(有时启动不起 可能是结构问题)。
    更改：
    STM0 CPU0 管理
    CCU60 CPU1 管理
    CCU61 CPU2 管理
    STM0 Systime 保留
    STM1 CH0 计算Bias
    STM1 CH1 舵机控制
    CCU60 CH0 电机控制
    [Cpu0_Main.c, devices_config.c, devices_config.h, icm20602.c, icm20602.h]
2021-04-26 Update.
    Motor 正常.
    Servo 正常.
    SESensor[7] 4095.
    更新了EQueue.
    更新了getnmsFlag.
    更新了Console.WriteArray() 方法.
    删除了dataprocess里的部分函数.
2021-05-02 Update
    Fix Error in Fuzzy Control.
    Fix Hardware SPI Macro Definition Bug.
    Update Reserved Data.
    Update Some Servo Parameter.
    Optimize Key Long Pressed Time.
    Add PID Output Limit.
    Add Limit to M_PID.
    Add Limit to S_PID.
    Delete Some Code In Foo.
    Delete Code Relative to CtrlSys.
    Delete Code Relative to Dictionary.
    [interrupt.c, key.c, key.h, lcd_driver.c, resource_config.c, servo.c]
2021-05-03 Update.
    Optimize PID Parameter.
    Optimize Bias Calculate.
2021-05-15 Update.
    更改了舵机中值、最大转角
    找到两个稳定的Kp：
    弯道 2.227 直道 0.8,其中Ki,Kd = 0.0
    动态系数0.000860，不稳定，待调
2021-05-16 Update.
    增加了Lock模块.
    优化了Queue 模块的Gets 和 Puts方法.
    丢线处理完成.
    环岛处理待完成.
    调整了部分参数.
    调整了部分函数命名.
2021-05-21 Update.
    正常寻迹
    转小弯连续
    能够判断直角
2021-05-22 20210522
    能过直角弯
    环岛能进
    十字会误判直角
    待完成：
    丢线处理
    十字
2021-05-23 20210523
    更正了Device Config 里的 SESensor的ADC映射关系。
2021-05-24 20210524
    更改了直角弯判断条件
    十字能识别出不来
    十字寻迹有问题
    [interrupt.c]
2021-05-25 20210525
    更改了直角弯和十字的判断条件
    直角弯和十字不会误判
    中入十字可以判断，出十字无法判断
2021-05-26 20210526
    队列代码测试正常
    丢线代码能初步处理丢线，还存在问题。
    丢线处理反应较慢
    加了变速代码
    [interrupt.c]
2021-05-29 20210529
    更改了元素判断方式(由宏转为inline函数)
    添加了速度更改标志位
    完成环岛处理
    更改了直角弯部分代码
    更改了丢线处理函数
    删除了十字冗余代码
2021-05-30 20210530
    更新了UI代码
    修正了FuzzyConrol部分代码
2021-06-01 20210601
    添加了CarMode = AI_Mode 部分代码
    更新了CarMode = AutoBoot_Mode部分代码
    修正了FuzzyControl数组越界的Bug.
    更正了NNCU部分ARM指令命名
    [interrupt.c]
2021-06-02 20210602
    更新了ADC引脚映射
    更新了ESensor映射
    电磁传感器完全正常
    更改了init.c
2021-06-03 20210603
    舵机使用模糊控制
    程序容易卡死
    直角弯出不来
2021-06-04 20210604
    环岛能进但不稳定
    环岛内会误判直角弯
2021-06-05 20210605
    更新了最小二乘法拟合斜率
2021-06-06 20210606
    用拟合斜率判断入环和直角
    反向入环太早
    直角弯待调
2021-06-09 20210609
    更新了舵机模糊规则
    更新了电机模糊PID
    更新了模糊查询车速
2021-06-10 20210611
    完成数据集采集
    更改了数据采集格式
    更改了数据处理函数结构
2021-06-11 20210612 - 1
    解决电机高占空比芯片复位的问题
    长前瞻寻迹基本完成，但还需优化
    初步编写了短前瞻寻迹算法
    短前瞻寻迹效果很差
    更改了模糊规则和论域
    加入了电机PID
2021-06-12 20210612
    更改了模糊规则表
    应用的模糊速度
    更改了直角弯处理函数
    更改了NNCU_Test函数
    长前瞻跑完全程
    问题：
    直角弯高速转弯半径太大
    电感线断了一根
2021-06-13 20210614 - 1
    优化了长前瞻寻迹
    长前瞻稳定跑完,稳定采集数据
    短前瞻传统算法低速正向稳定
    反向环岛入早了
    加入了按键控制采集数据
    加入了拨码开关选择模式
    AI目前效果不好
2021-06-14 20210614
    对element里不同CarMode的代码进行了整合、优化。
    短前瞻加了丢线处理
    短前瞻略微提速，靠近信号源的直角弯出来会误判丢线
    模型初步跑通，低速下寻迹基本正常，但特殊元素会误判，而且正常寻迹会贴着边线跑
    计算电机传递函数中。。。
2021-06-16 20210616
    短前瞻问题修复
    更改了长短前瞻的模糊规则表
    短前瞻提速，但极其不稳定
    AI提速，可以正常寻迹,基本贴合中线，急弯/直角过不去。
    更改了舵机中值及范围
    更改了环岛的参数
    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
    [devices_config.c]
2021-06-18 20210618
    思路有点乱,理一理
2021-06-20 20210620
    AI基本能跑完全程(除了十字附近的直角弯)。
    柱子一圈贴外圈，原因：原本寻迹效果不到，导致数据不好。
    加入了直道大偏差以及直角数据集
    对之前的数据集做了备份。
    更改了frand函数实现
    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
    [Configuration.h, ConfigurationIsr.h, Parameter-00011.txt, Parameter-00012.txt, Parameter-00013.txt, Parameter-00014.txt, Parameter-00015.txt, Parameter-00033.txt]
2021-06-21 20210621
    更改了阶跃信号的幅度
2021-06-22 20210623-1
    更新电磁板
2021-06-23 20210624-1
    铺设大赛道
    坡道会误判环岛
    小环有时会进不去
    更改了直角弯处理方式
    连续直角高速有问题
    [Configuration.h, ConfigurationIsr.h]
2021-06-25 20210626 - 1
    低速直角稳定入环
    高速直角斜入环岛能识别，但无法处理
    增加了测距传感器
    添加了元素间异常信息传递。
    [Configuration.h, ConfigurationIsr.h]
2021-06-26 20210627 - 1
    大赛道
    长前瞻 2000 2200 稳定跑完
    2500 直角2000 稳定跑完
    AI效果不行
    大赛道需要进行弯道特训
    [Parameter-00011-小赛道.txt, Parameter-00012-小赛道.txt, Parameter-00013-小赛道.txt, Parameter-00014-小赛道.txt, Parameter-00015-小赛道.txt, Parameter-00048-大赛道反2.txt, Parameter-00049-大赛道正2.txt, Parameter-00050-大赛道正2.txt]
2021-06-26 20210627 - 1
    压缩包备份
2021-06-28 20210628
    增加了数据采集代码打包
    增加了急弯判断
    更改了环岛入环打角时间计算
2021-06-28 20210628
    增加环岛判断条件，以防止坡道误判
2021-07-02 20210703 - 1
    加入了AI模型的角度修正
    增加了大赛道加噪声
    更改了数据保存方式
    [Configuration.h, ConfigurationIsr.h]
2021-07-03 20210704 - 1
    AI能跑完全程(但无法过十字,会误判成直角)
    修复了SD.fastWrite bug.
    添加了数据采集分类
    添加了直道和弯道判断
2021-07-10 20210711 - 1
    AI Speed 2000(1.5m/s) - 2500 反向稳定跑完，
    2600 稍抖
    环岛不能稳进，需要加强
    正向待修正
    正向环岛不能进
2021-07-12 20210713 - 1
    正向稳入环！
    直道修正
2021-07-20 20210720
    华东赛区比赛完成备份
    [Configuration.h, ConfigurationIsr.h, Parameter-00000.txt, Parameter-00001.txt, Parameter-00002.txt, Parameter-00003.txt, Parameter-00004.txt, Parameter-00005.txt]
2021-07-21 20210721
    对代码进行了简化.
    结构、逻辑更清晰.
2021-07-22 20210722
    整理并精简代码
    HESensor定义更改.
2021-07-23 20210723
    将元素部分的参数打包
2021-07-26 20210726
    调电机PIDing.
    效果不ok。
2021-07-27 20210727
    更改了陀螺仪读取速度.
2021-07-29 20210729
    添加了自校准程序.
    将一些参数存入EEPROM.
2021-07-30 20210730
    将Save/Read EEPROM 函数放进ui.c
    更改了拨码开关对应的操作
    添加了清除EEPROM和使用EEPROM模式
    改变了UI初始化的位置
    自校准程序校准竖电感会卡死
2021-07-31 20210731
    更新了 ADRC Control.
2021-08-01 20210801
    调ADRC调坏了驱动
    摸鱼ing.
2021-08-18 20210818
    AI Speed 2000 几字弯过不去.
    采集的新数据加到原来数据集，效果不好
