GTshenmi/AI-SmartCar/(notices)

Notices in the files:
AI Electomagnetic/Software/Template/TC377/Driver/UsrDriver/MPU9250/mpu9250.h:
Copyright(C) ¹ãÖÝÊÐÐÇÒíµç×Ó¿Æ¼¼ÓÐÏÞ¹«Ë¾ 2014-2024
All rights reserved
